ArminJo/Arduino-OpenWindowAlarm/pictures/ArduinoDigisparkBoardSelection.png

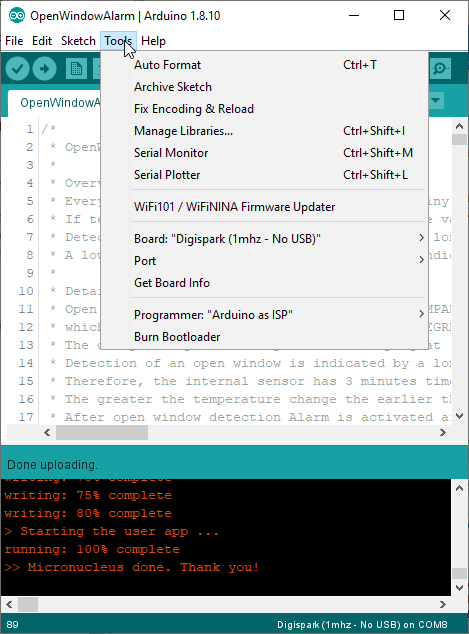
pictures/ArduinoDigisparkBoardSelection.png
