ArminJo/Arduino-OpenWindowAlarm/pictures/OpenWindowAlarm.png

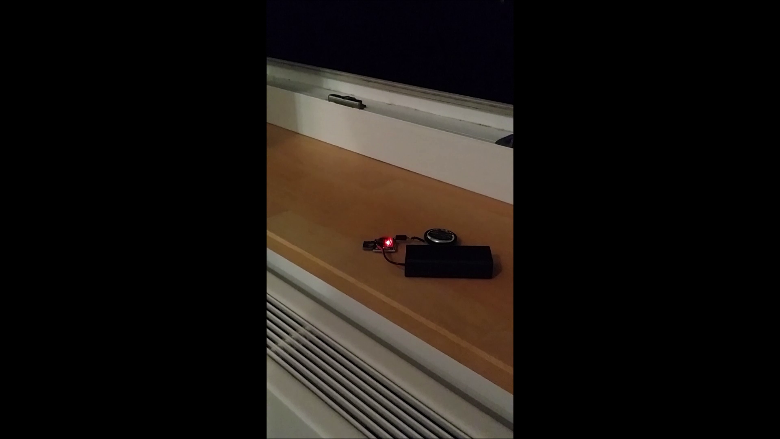
pictures/OpenWindowAlarm.png
