ArminJo/Arduino-OpenWindowAlarm/pictures/OpenWindowAlarmLiPo.jpg

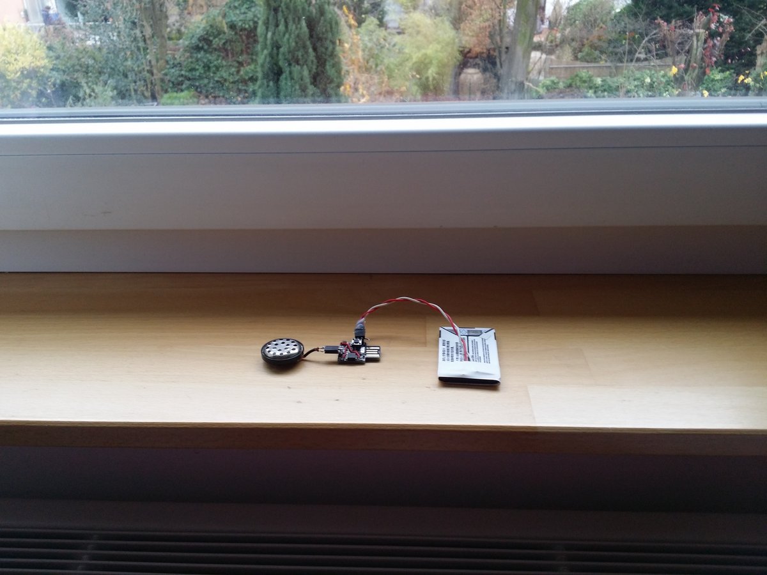
pictures/OpenWindowAlarmLiPo.jpg
