ArminJo/Arduino-OpenWindowAlarm/pictures/Patch.jpg

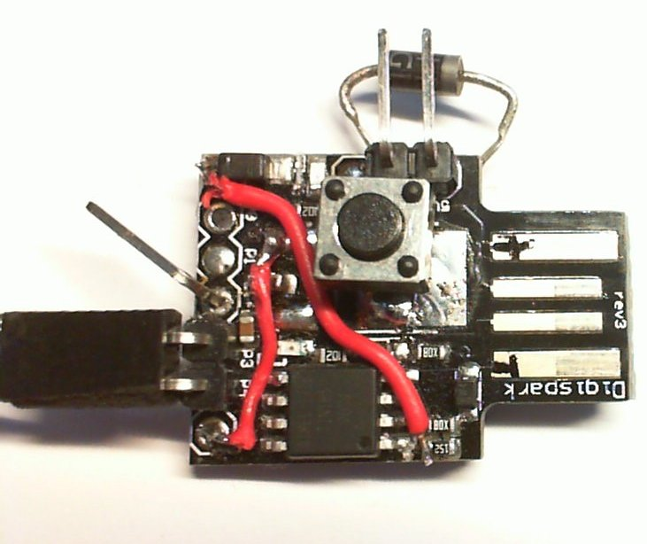
pictures/Patch.jpg
