ArminJo/Arduino-OpenWindowAlarm/pictures/PartsAll_annotated.jpg

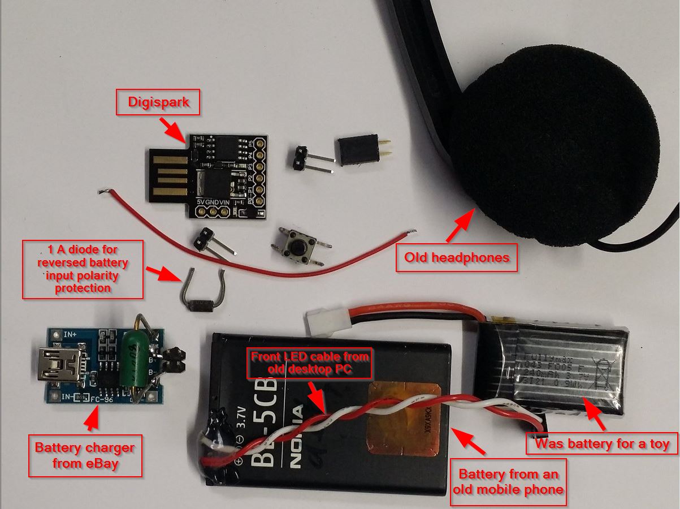
pictures/PartsAll_annotated.jpg
