ArminJo/Arduino-OpenWindowAlarm/(commit log)

2018-12-13 Files for bootloader for USB Power Bank operation
2019-11-07 Version1.2.2 - Converted to Serial.print + New PWMTone() without tone()
2019-11-19 Version 1.3 - Voltage detection
2020-05-28 Adapted to new Digispark board configuration
