ArminJo/Arduino-OpenWindowAlarm/(notices)

Notices in the files:
OpenWindowAlarm/OpenWindowAlarm.ino:
Arduino-OpenWindowAlarm is free software: you can redistribute it and/or modify
it under the terms of the GNU General Public License as published by
the Free Software Foundation, either version 3 of the License, or
(at your option) any later version.
along with this program. If not, see <http://www.gnu.org/licenses/gpl.html>.
README.md:
License: GPL v3
